akita11/FuruDisplay/README.md

# FuruDisplay
Versa-Writer, POV Display with scan capability
