akita11/FuruDisplay/FDman.pdf

# ふるディスプレイをつくろう！

# 金沢大学 秋田純一(@akita11) akita@ifdL.jp

# ふるディスプレイとは

# - ふると、残像で文字・模様が見えます - 紙に書いた模様を取り込みできます

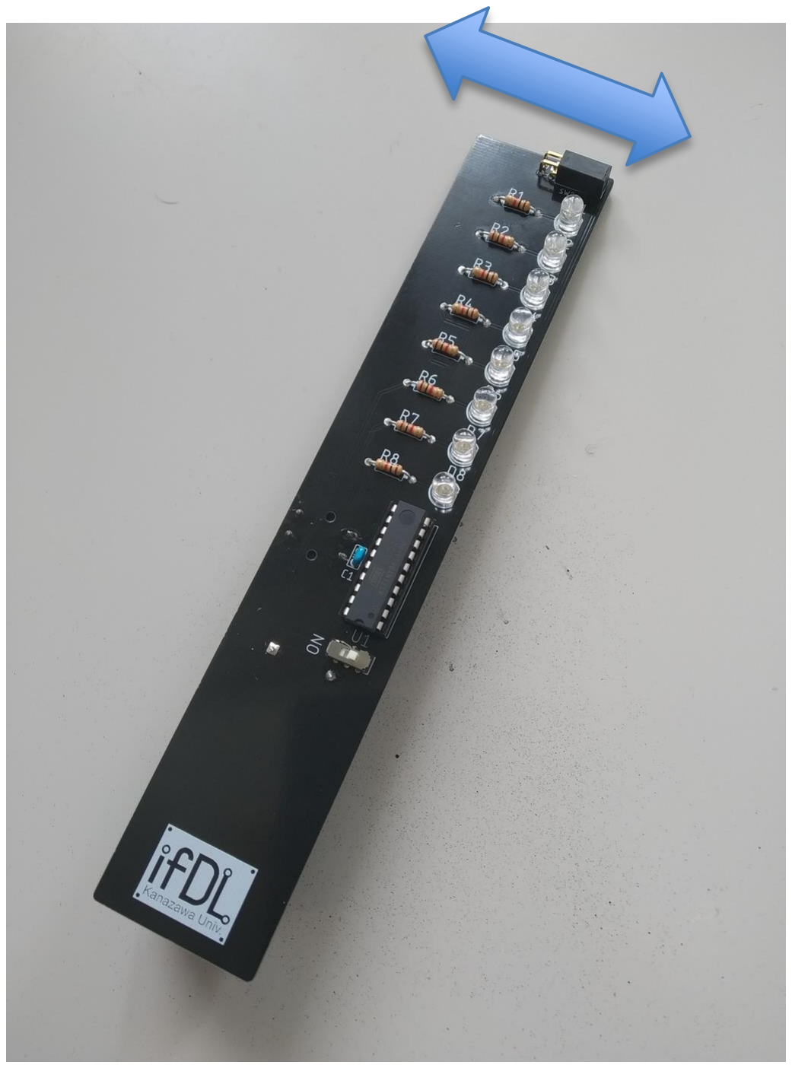
[picture p1: figure]

# 注意事項

# - はんだごてで、はんだを「とかして」組み立て ていきます - はんだは、200度くらいでとける金属です - つまり、はんだごての先たんは 「めちゃくちゃ熱い」 - ぜっっったいに、さわらないように！！！

# 使う道具

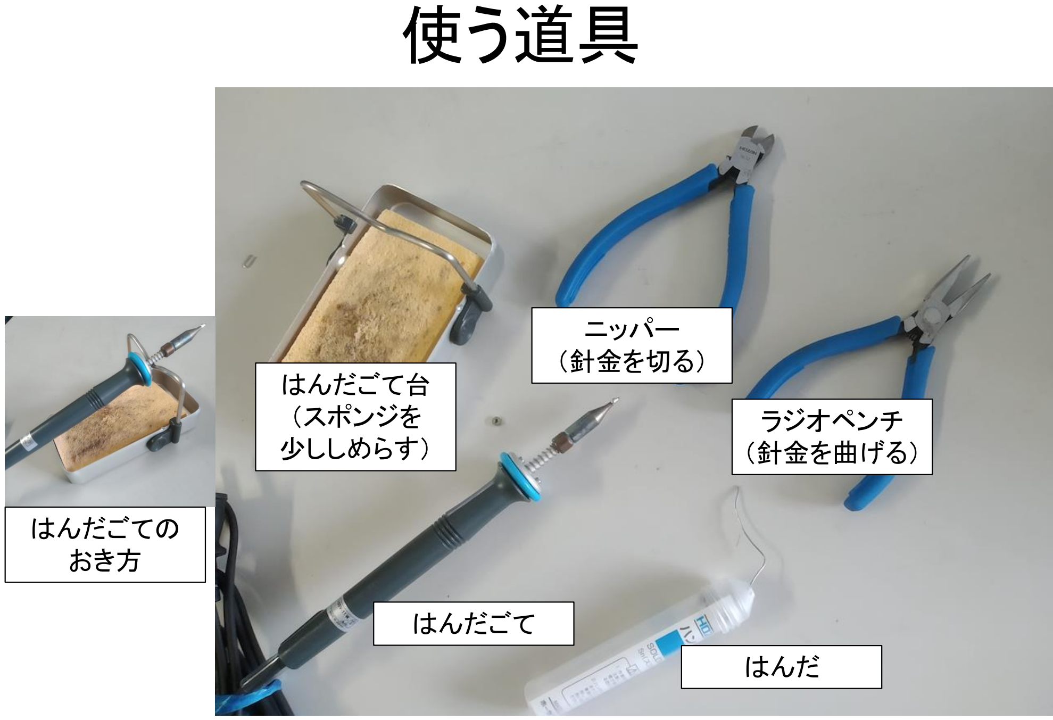
[picture p2: page 4]

ニッパー
（針金を切る）

ラジオペンチ
（針金を曲げる）

はんだごて台
（スポンジを
少ししめらす）

はんだごて
はんだ

はんだごての
おき方

# はんだ付けのコツ

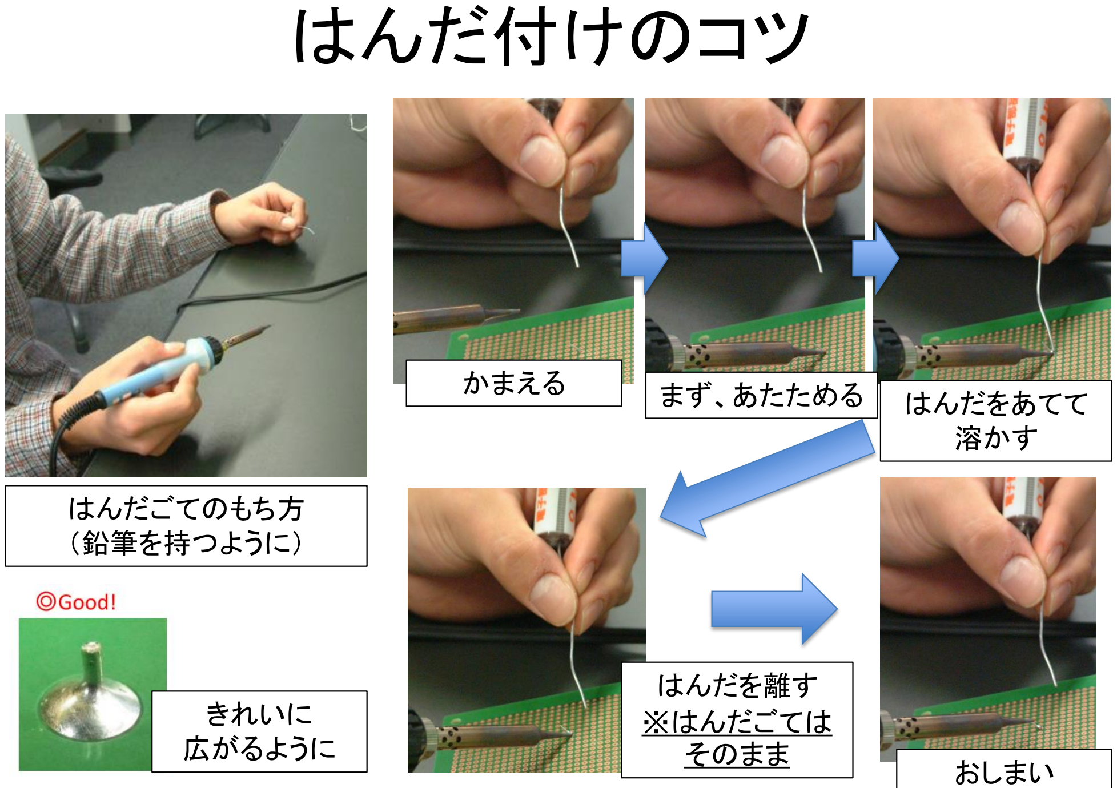
[picture p3: page 5]

はんだごてのもち方
（鉛筆を持つように）
かまえる | まず、あたためる | はんだをあてて
| | 溶かす

はんだを離す
※はんだごては
そのまま | おしまい

きれいに
広がるように

# 部品の確認

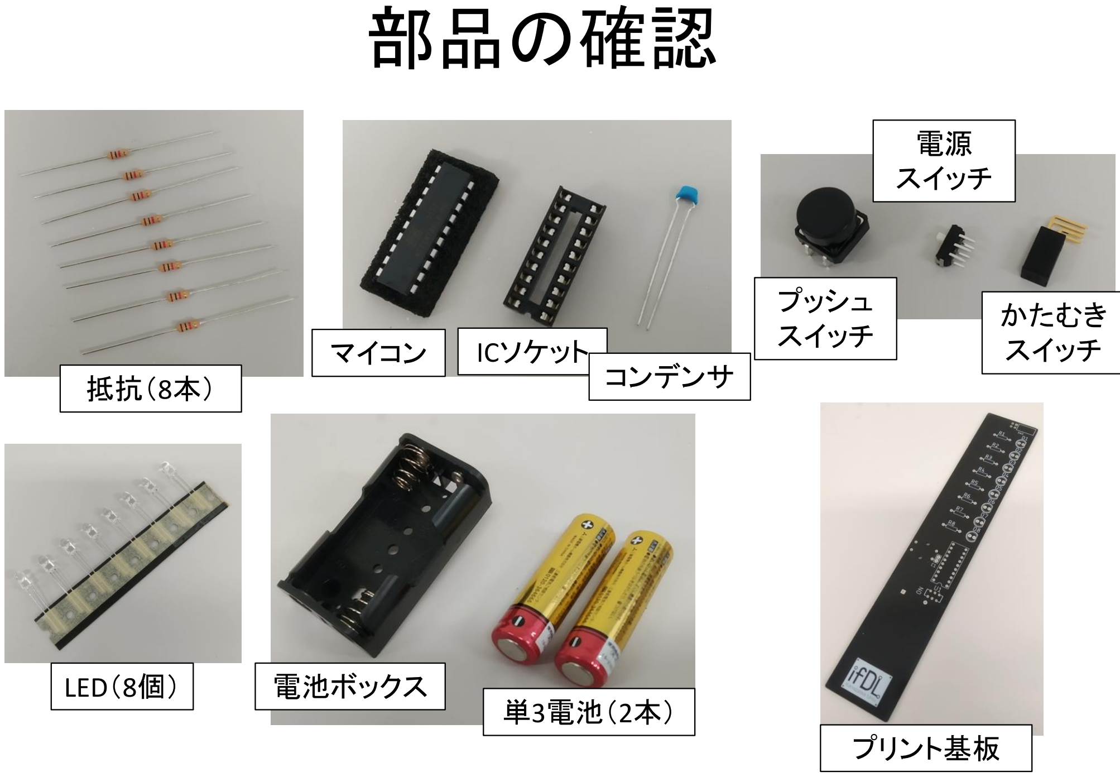
[picture p4: page 6]

抵抗（8本）

マイコン ICソケット
コンデンサ

プッシュ
スイッチ

電源
スイッチ

かたむき
スイッチ
LED（8個） | 電池ボックス
単3電池（2本）
プリント基板

# 抵抗のとりつけ（１）

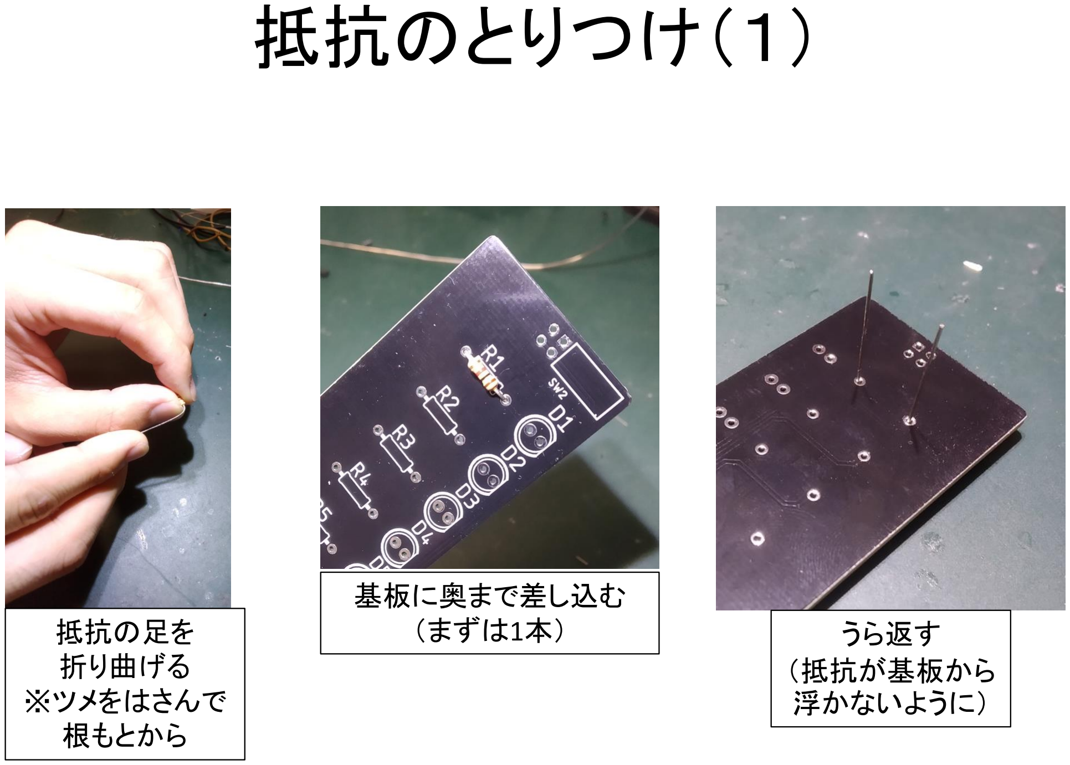
[picture p5: page 7]

抵抗の足を
折り曲げる
※ツメをはさんで
根もとから

基板に奥まで差し込む
（まずは1本） | うら返す
| （抵抗が基板から 浮かないように）

# 抵抗のとりつけ（２）

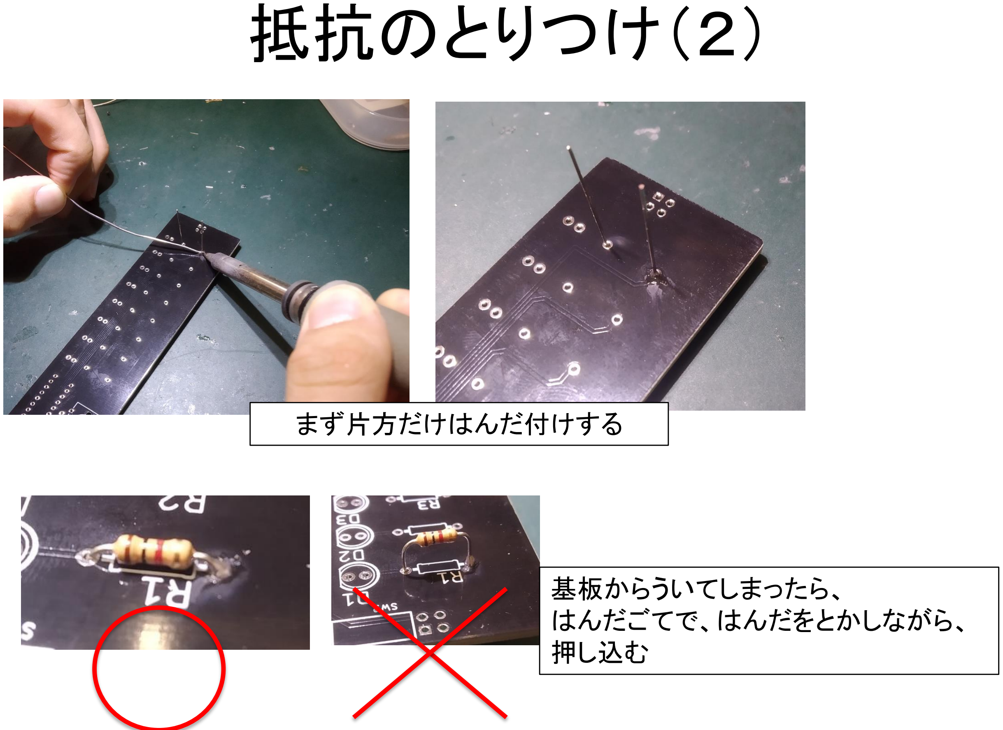
[picture p6: page 8]

まず片方だけはんだ付けする

基板からういてしまったら、
はんだごてで、はんだをとかしながら、
押し込む

# 抵抗のとりつけ（３）

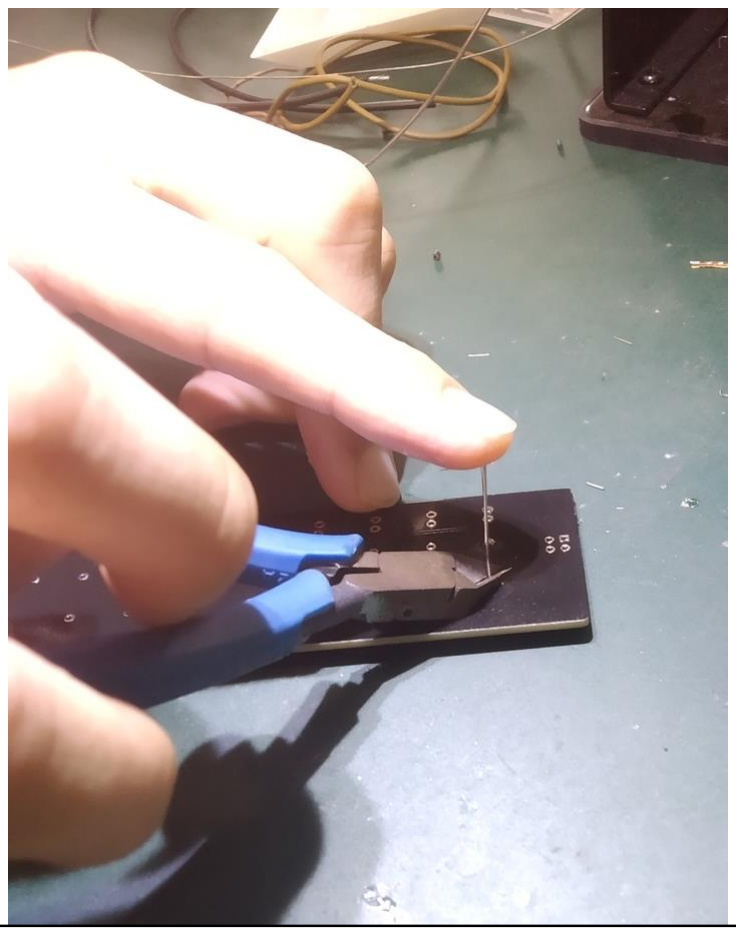
[picture p7: figure]

ニッパーで足を切り取る
※もう片方の手の指で、
足を押さえながら

この調子で、もう片方の足をはんだ付けし、
残り7本の抵抗をとりつけて、はんだ付け

# コンデンサのとりつけ

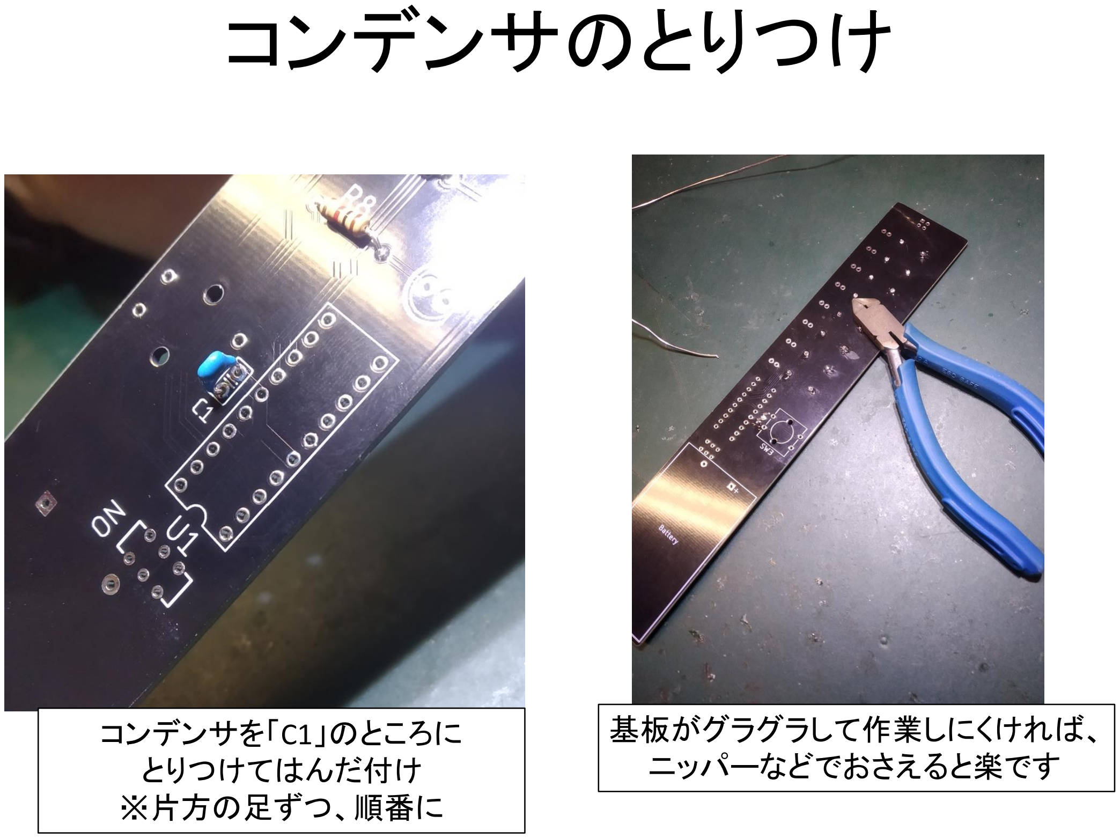
[picture p8: page 10]

コンデンサを「C1」のところに
とりつけてはんだ付け
※片方の足ずつ、順番に

基板がグラグラして作業しにくければ、
ニッパーなどでおさえると楽です

# ICソケットのとりつけ（１）

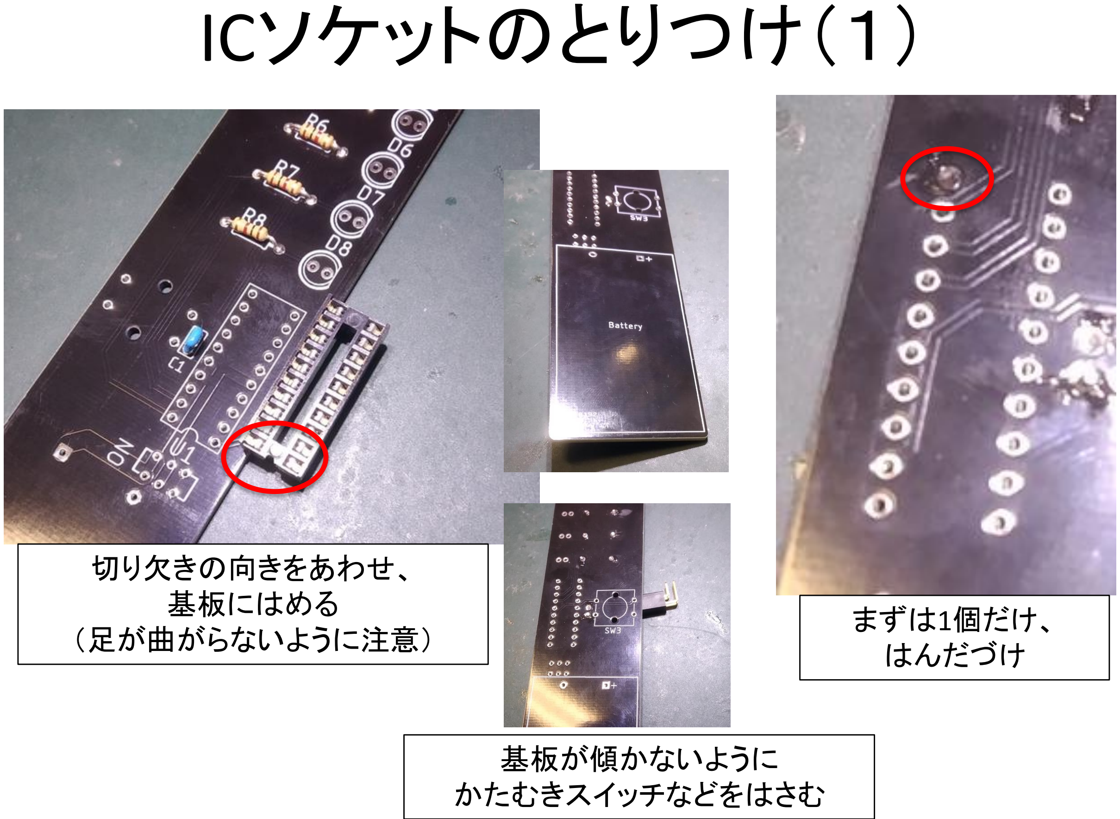
[picture p9: page 11]

切り欠きの向きをあわせ、
基板にはめる
（足が曲がらないように注意）

基板が傾かないように
かたむきスイッチなどをはさむ

まずは1個だけ、
はんだづけ

# ICソケットのとりつけ（２）

# - ICソケットが基板から浮いたり、かたむいたり していないかをよく確認する

## – 傾いていたら、はんだをとかして、押し込む

# - その後、残り19個をはんだ付けする

# スイッチのとりつけ（2種類）

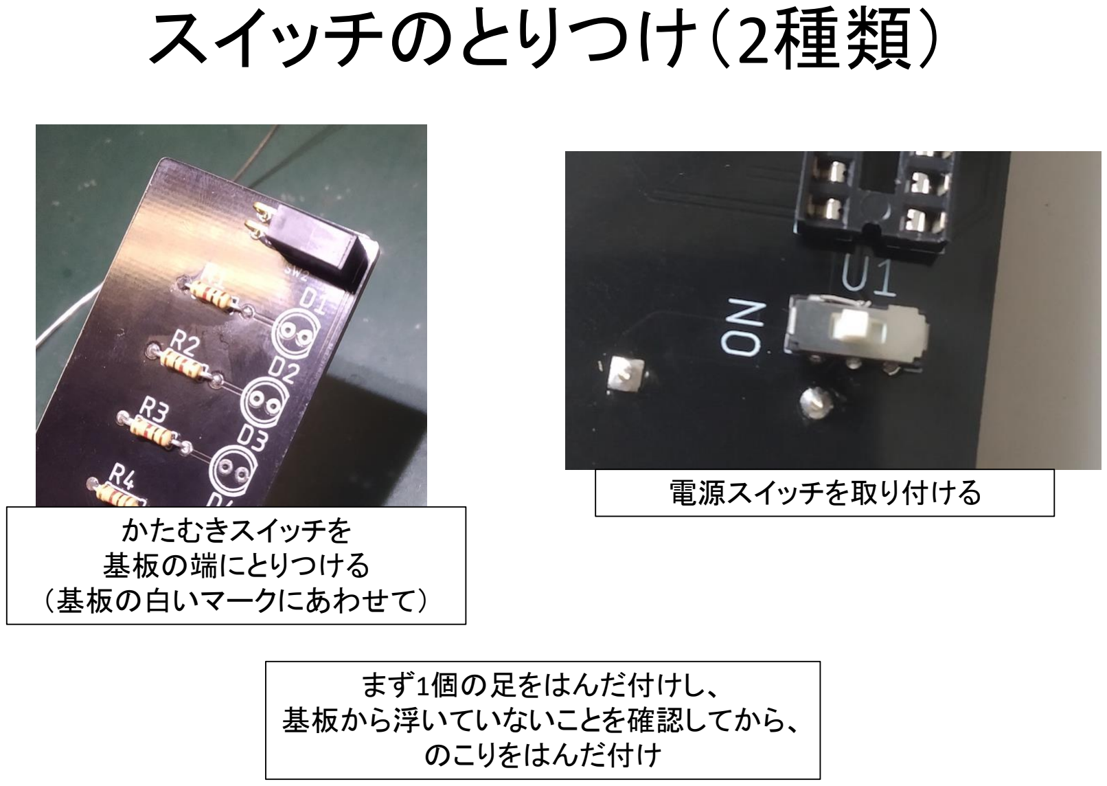
[picture p10: page 13]

かたむきスイッチを
基板の端にとりつける
（基板の白いマークにあわせて）

電源スイッチを取り付ける

まず1個の足をはんだ付けし、
基板から浮いていないことを確認してから、
のこりをはんだ付け

# LEDの準備

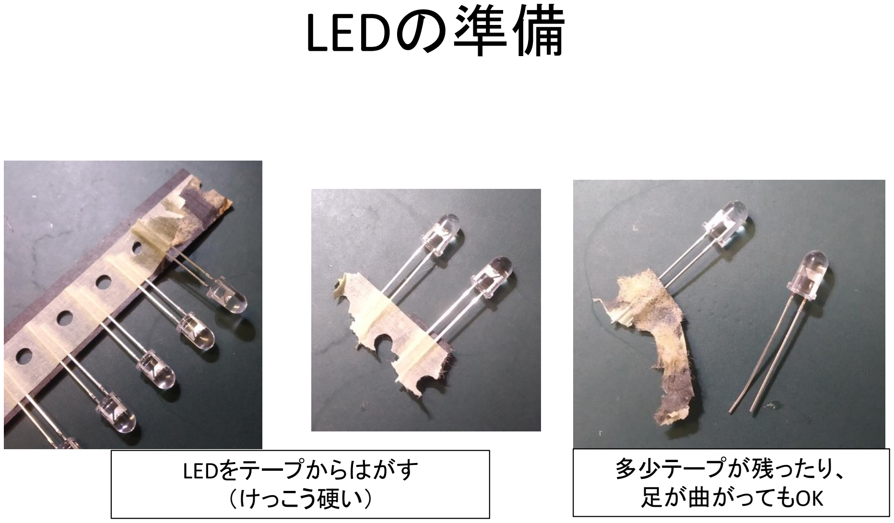
[picture p11: page 14]

LEDをテープからはがす
（けっこう硬い）

多少テープが残ったり、
足が曲がってもOK

# LEDのとりつけ

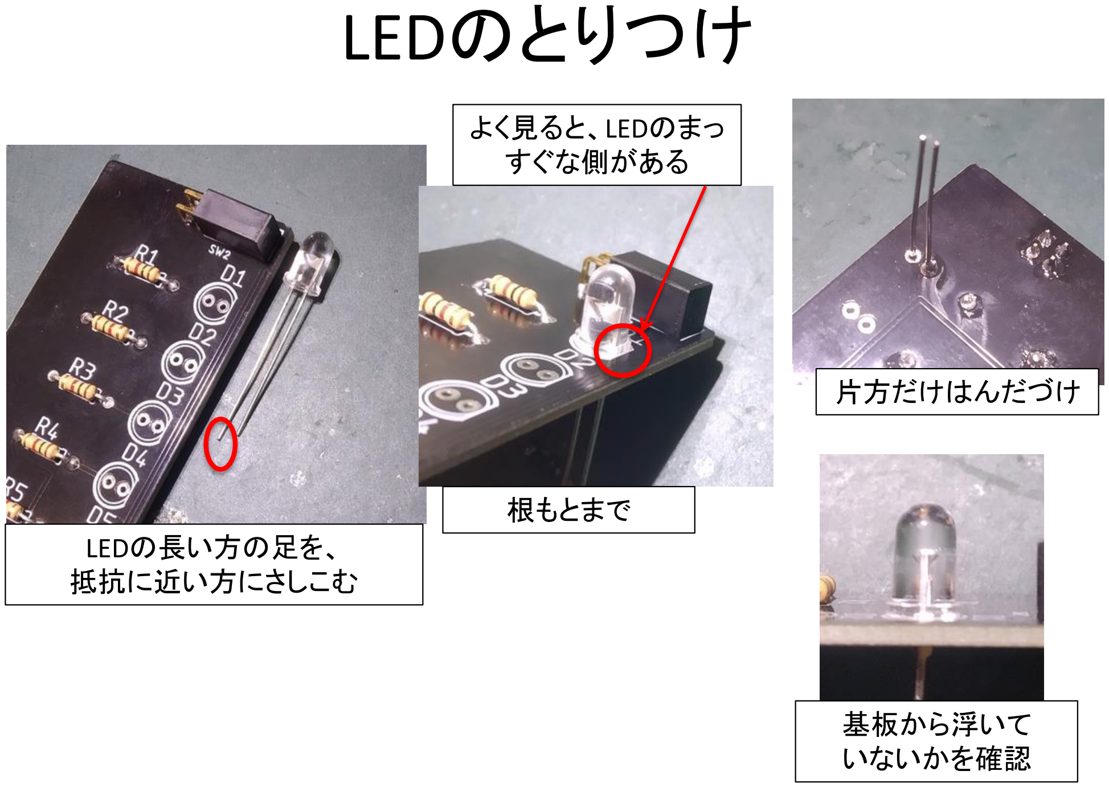
[picture p12: page 15]

LEDの長い方の足を、
抵抗に近い方にさしこむ

根もとまで

片方だけはんだづけ

基板から浮いて
いないかを確認

よく見ると、LEDのまっ
すぐな側がある

# ここから、基板の反対側に部品 をとりつけます

# プッシュスイッチの取り付け

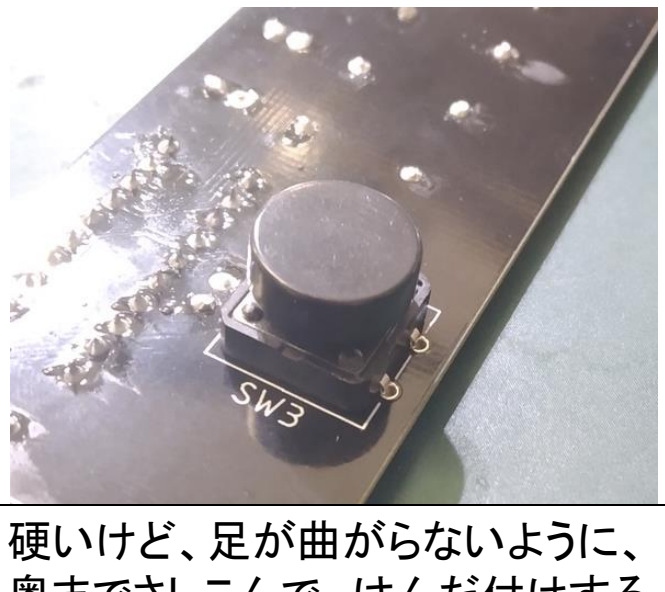
[picture p13: figure]
硬いけど、足が曲がらないように、

奥までさしこんで、はんだ付けする

# 電池ボックスのとりつけ

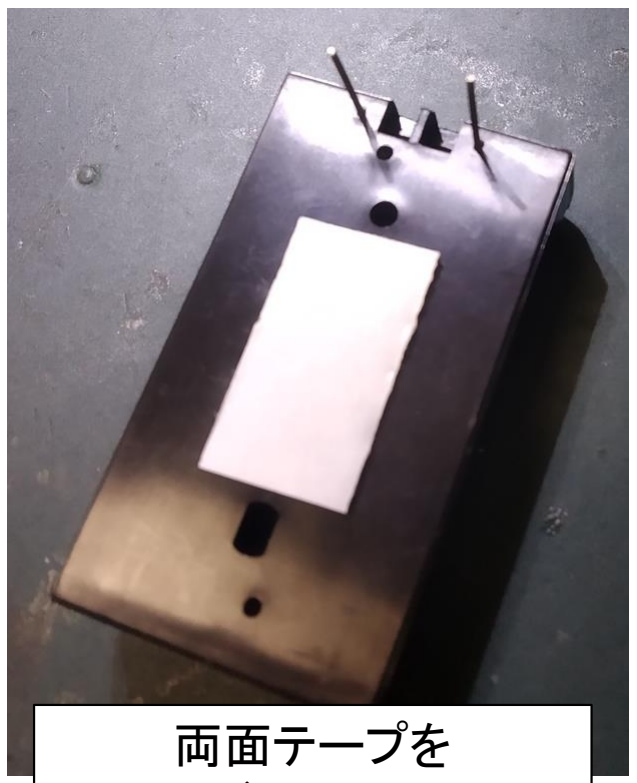
[picture p14: figure]
両面テープを

電池ボックスにはる

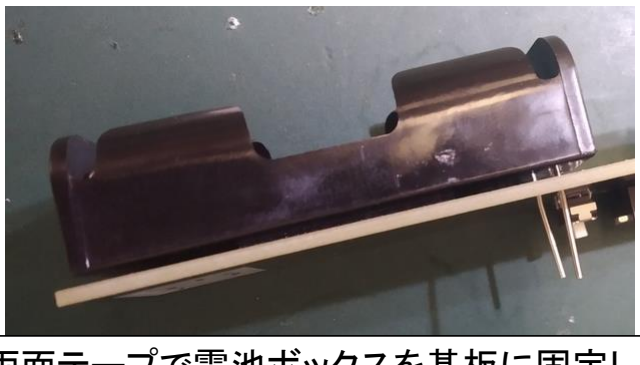
[picture p15: figure]

両面テープで電池ボックスを基板に固定し、
はんだづけ

# マイコンのとりつけ

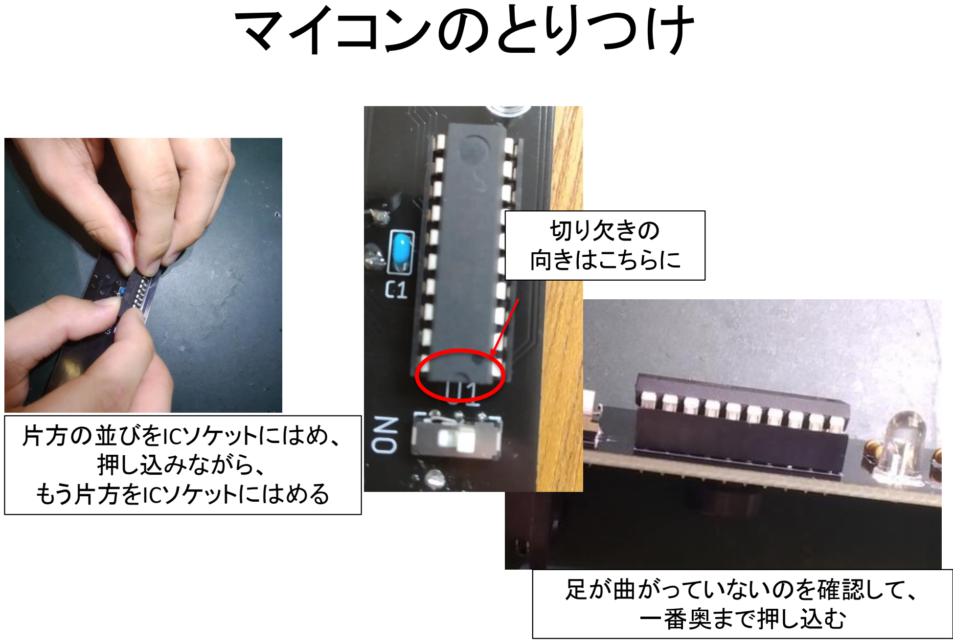
[picture p16: page 19]

片方の並びをICソケットにはめ、
押し込みながら、
もう片方をICソケットにはめる

足が曲がっていないのを確認して、
一番奥まで押し込む

切り欠きの
向きはこちらに

完成！

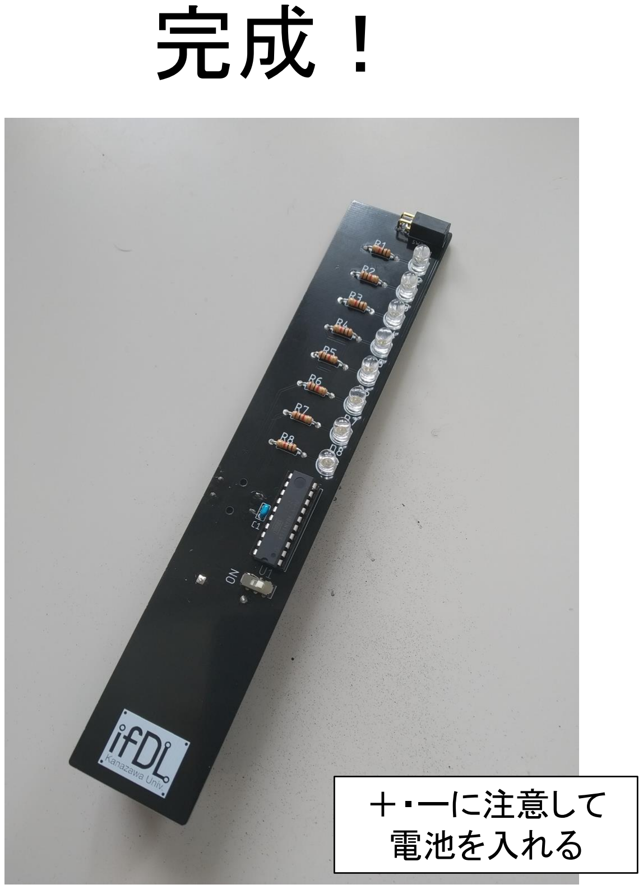
[picture p17: page 20]

＋・ーに注意して
電池を入れる

# あそび方（１）

# - 電源スイッチON！ - ふる→残像で文字・模様が見える！

## – ふるスピードは、うまく調整しよう

# - スイッチを押すと、パターンが変わる（８種類）

## – 表示されるパターンは点滅するLEDの位置で確認

# あそび方（２−１）

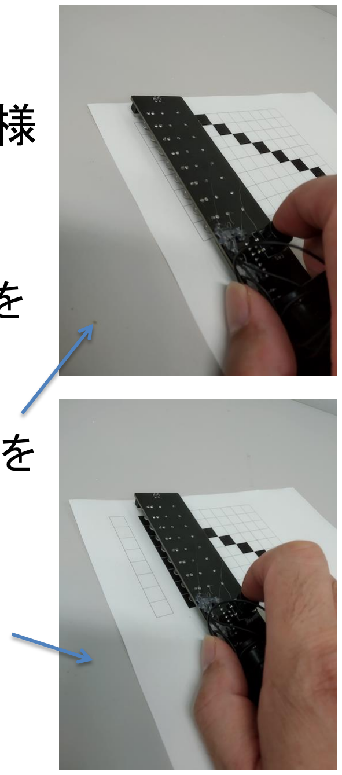
[picture p18: figure]

## - 10mmマスの方眼紙に、黒マジックで模様 をかく（最後のページにもあります） - スキャンする

## – 保存（上書き）したいパターンを、スイッチを 押して選択 – スイッチを長押し→LEDが5回点滅する – 裏返して、白いところにLEDをあてスイッチを

押す

## →LEDが点滅するまでそのまま（2回行う） – 黒いところにLEDをあてスイッチを押す →LEDが点滅するまでそのまま（2回行う） ※2回目はLEDが2回点滅

# あそび方（２−２）

## - スキャンする（つづき）

## – 模様の一列ずつ、LEDをあててスイッチを押す →LEDが2回点滅し、黒いところのLEDのみ2回点滅 – スキャンが終わったらスイッチを長押し→LEDが5回点

滅

## – ふって、見える模様を確認 →OKなら、スイッチを長押しして保存（LEDが高速に点

滅）

## - （おまけ）スイッチを押した状態で電源ON→5秒 間そのまま→LED点滅→いったん離してからもう 一度長押し、で初期化
