akita11/FuruDisplay/FD1_bom.xlsx

 |  | 個数 | 単価 | 価格 | URL | トータル個数
MCU | ATtiny861 | 1 | 220 | 220 | http://akizukidenshi.com/catalog/g/gI-04301/ | 45
LED | 広角緑 LC503PPG1-30Q | 8 | 10 | 80 | http://akizukidenshi.com/catalog/g/gI-13231/ | 360
抵抗 | 1k 1/4W | 8 | 1 | 8 | http://akizukidenshi.com/catalog/g/gR-25102/ | 360
TactSW | TVGP01-G73BB | 1 | 30 | 30 | http://akizukidenshi.com/catalog/g/gP-09826/ | 45
TiltSW | RBS040210-G | 1 | 100 | 100 | http://akizukidenshi.com/catalog/g/gP-11714/ | 45
PowerSW | IS2235 | 1 | 25 | 25 | http://akizukidenshi.com/catalog/g/gP-02627/ | 45
電池BOX |  | 1 | 40 | 40 | http://akizukidenshi.com/catalog/g/gP-03086/ | 45
電池 |  | 2 |  | 0
 |  |  | 合計 | 503
 |  |  | 台数 | 45
 |  |  |  | 22635
