akita11/FuruDisplay/FD1.brd

## EAGLE design FD1.brd (2019-08-07)

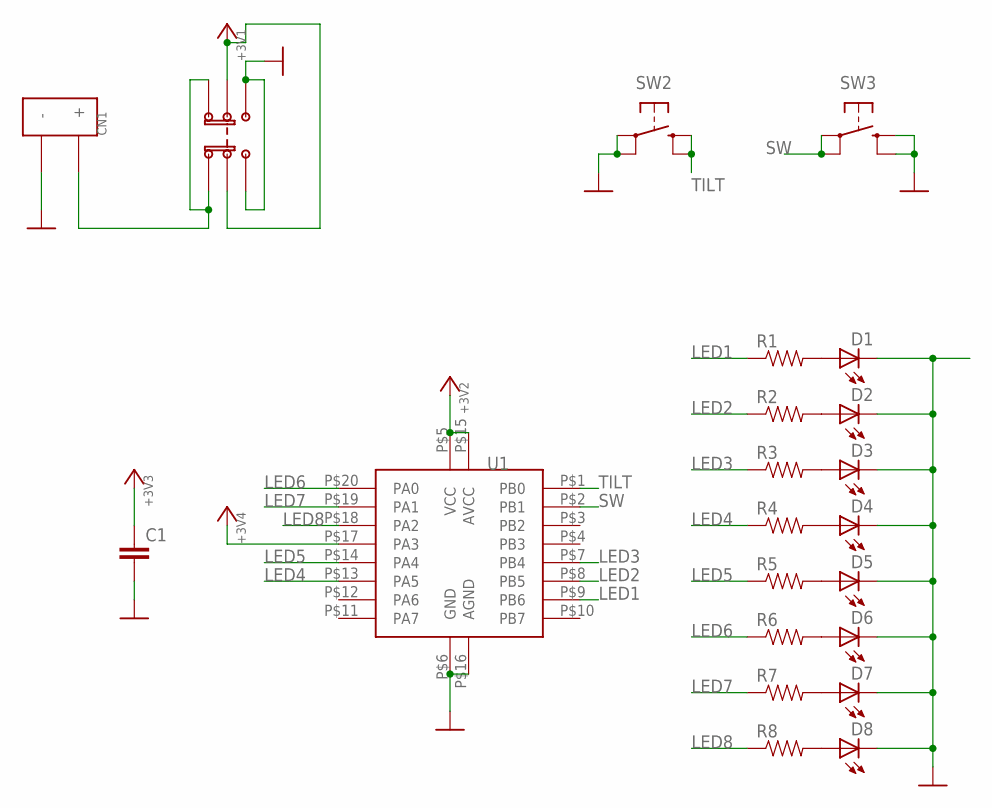
[picture p19: schematic FD1.sch]

Parts:
C1: CAPTH_5MML; CAP_TH_5MM_L
CN1: BAT_UM3X2
D1, D2, D3, D4, D5, D6, D7, D8: LED5MM; SPARKFUN_LED5MM
R1, R2, R3, R4, R5, R6, R7, R8: RESTH_10MML; R_TH_10MM_L
SW2: SW_TACTRBS04021-G; SW_RBS040210-G
SW3: SW_TACTTH_L; SW_TACT_L
SW4: SW_IS-1250IS2235; SW_IS2235
U1: MCU_ATTINY861PU; DIP20

Connections:
+3V3: C1.1, SW4.P$C1, SW4.P$C2, U1.P$5 (VCC), U1.P$15 (AVCC), U1.P$17 (PA3)
GND: C1.2, CN1.P$M (-), D1.K (C), D2.K (C), D3.K (C), D4.K (C), D5.K (C), D6.K (C), D7.K (C), D8.K (C), SW2.P$1, SW2.P$2 (P1), SW3.P$3 (S), SW3.P$4 (S1), SW4.P$B1, SW4.P$B2, U1.P$6 (GND), U1.P$16 (AGND)
LED1: R1.1, U1.P$9 (PB6)
LED2: R2.1, U1.P$8 (PB5)
LED3: R3.1, U1.P$7 (PB4)
LED4: R4.1, U1.P$13 (PA5)
LED5: R5.1, U1.P$14 (PA4)
LED6: R6.1, U1.P$20 (PA0)
LED7: R7.1, U1.P$19 (PA1)
LED8: R8.1, U1.P$18 (PA2)
unnamed: CN1.P$P (+), SW4.P$A1, SW4.P$A2
unnamed: D1.A, R1.2
unnamed: D2.A, R2.2
unnamed: D3.A, R3.2
unnamed: D4.A, R4.2
unnamed: D5.A, R5.2
unnamed: D6.A, R6.2
unnamed: D7.A, R7.2
unnamed: D8.A, R8.2
SW: SW3.P$1, SW3.P$2 (P1), U1.P$2 (PB1)
TILT: SW2.P$3 (S), SW2.P$4 (S1), U1.P$1 (PB0)

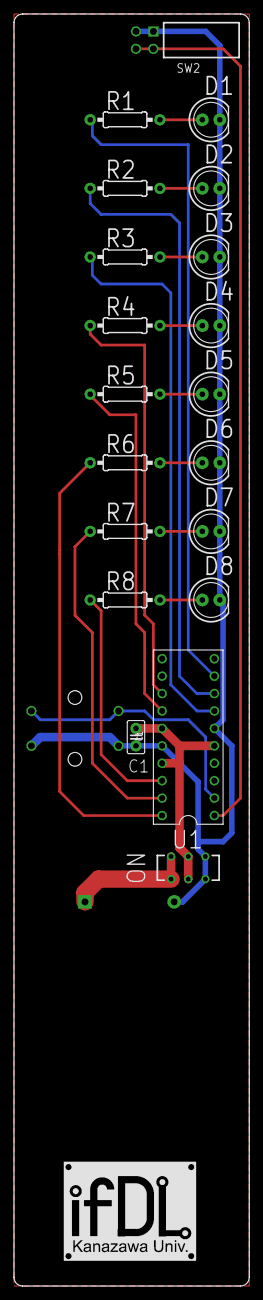
[picture p20: board FD1.brd from above]

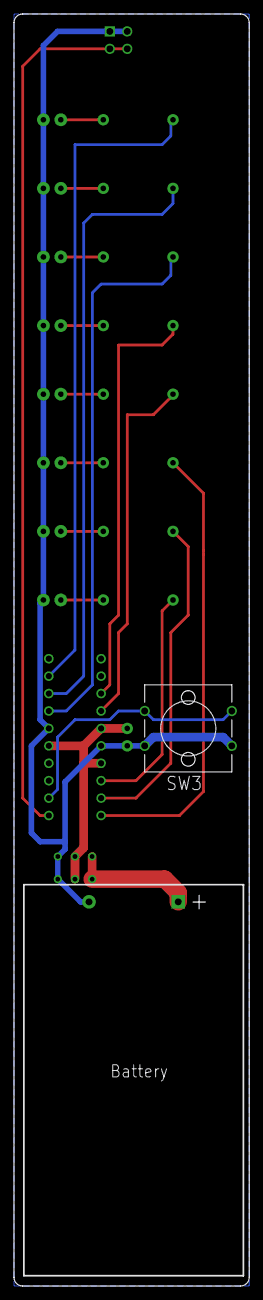
[picture p21: board FD1.brd from below]

Board: 2 copper layers, 34.3 x 185.4 mm, 22 parts (2 on the bottom side), 21 nets.
